colinmarc/novy/hardware/chain.png

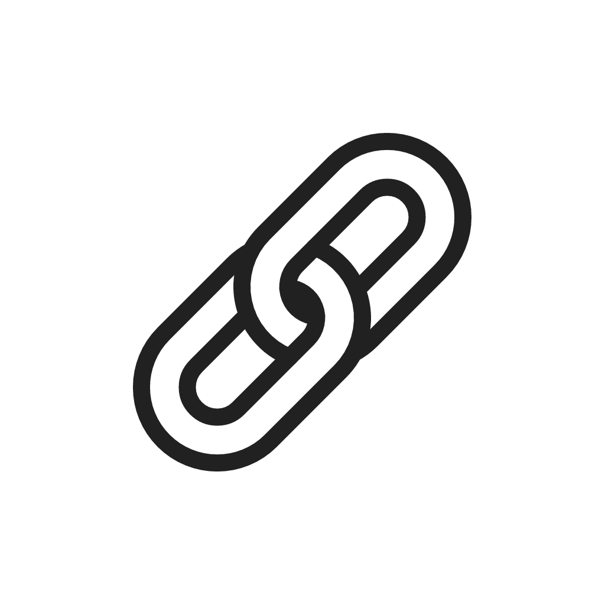
hardware/chain.png
