colinmarc/novy/hardware/front.dxf

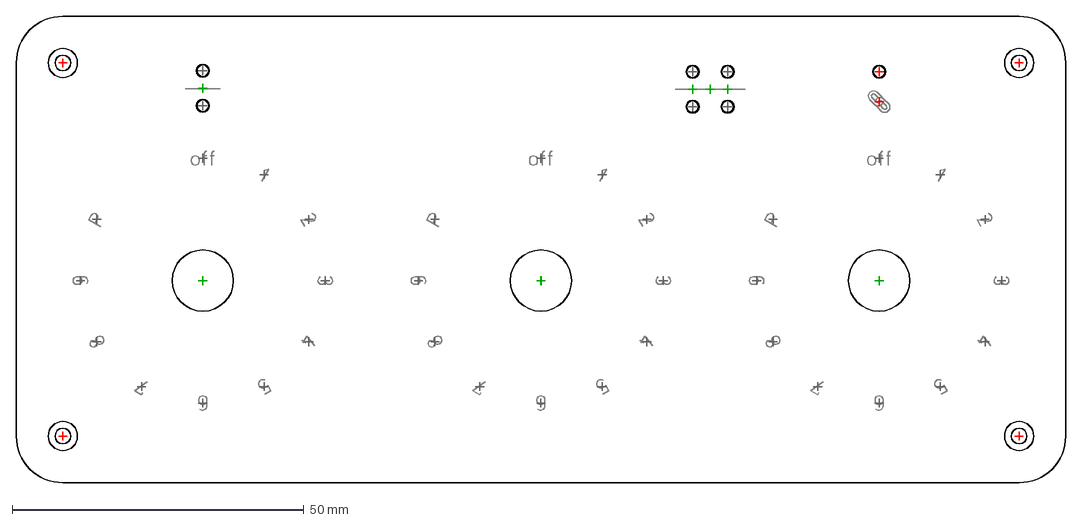
[picture p2: CAD file, 2026-05-25]
hardware/front.dxf
180.0 x 80.0 mm
