colinmarc/novy/hardware/novy/novy.kicad_pcb

## KiCad design hardware/novy/novy.kicad_pcb (2026-07-04)

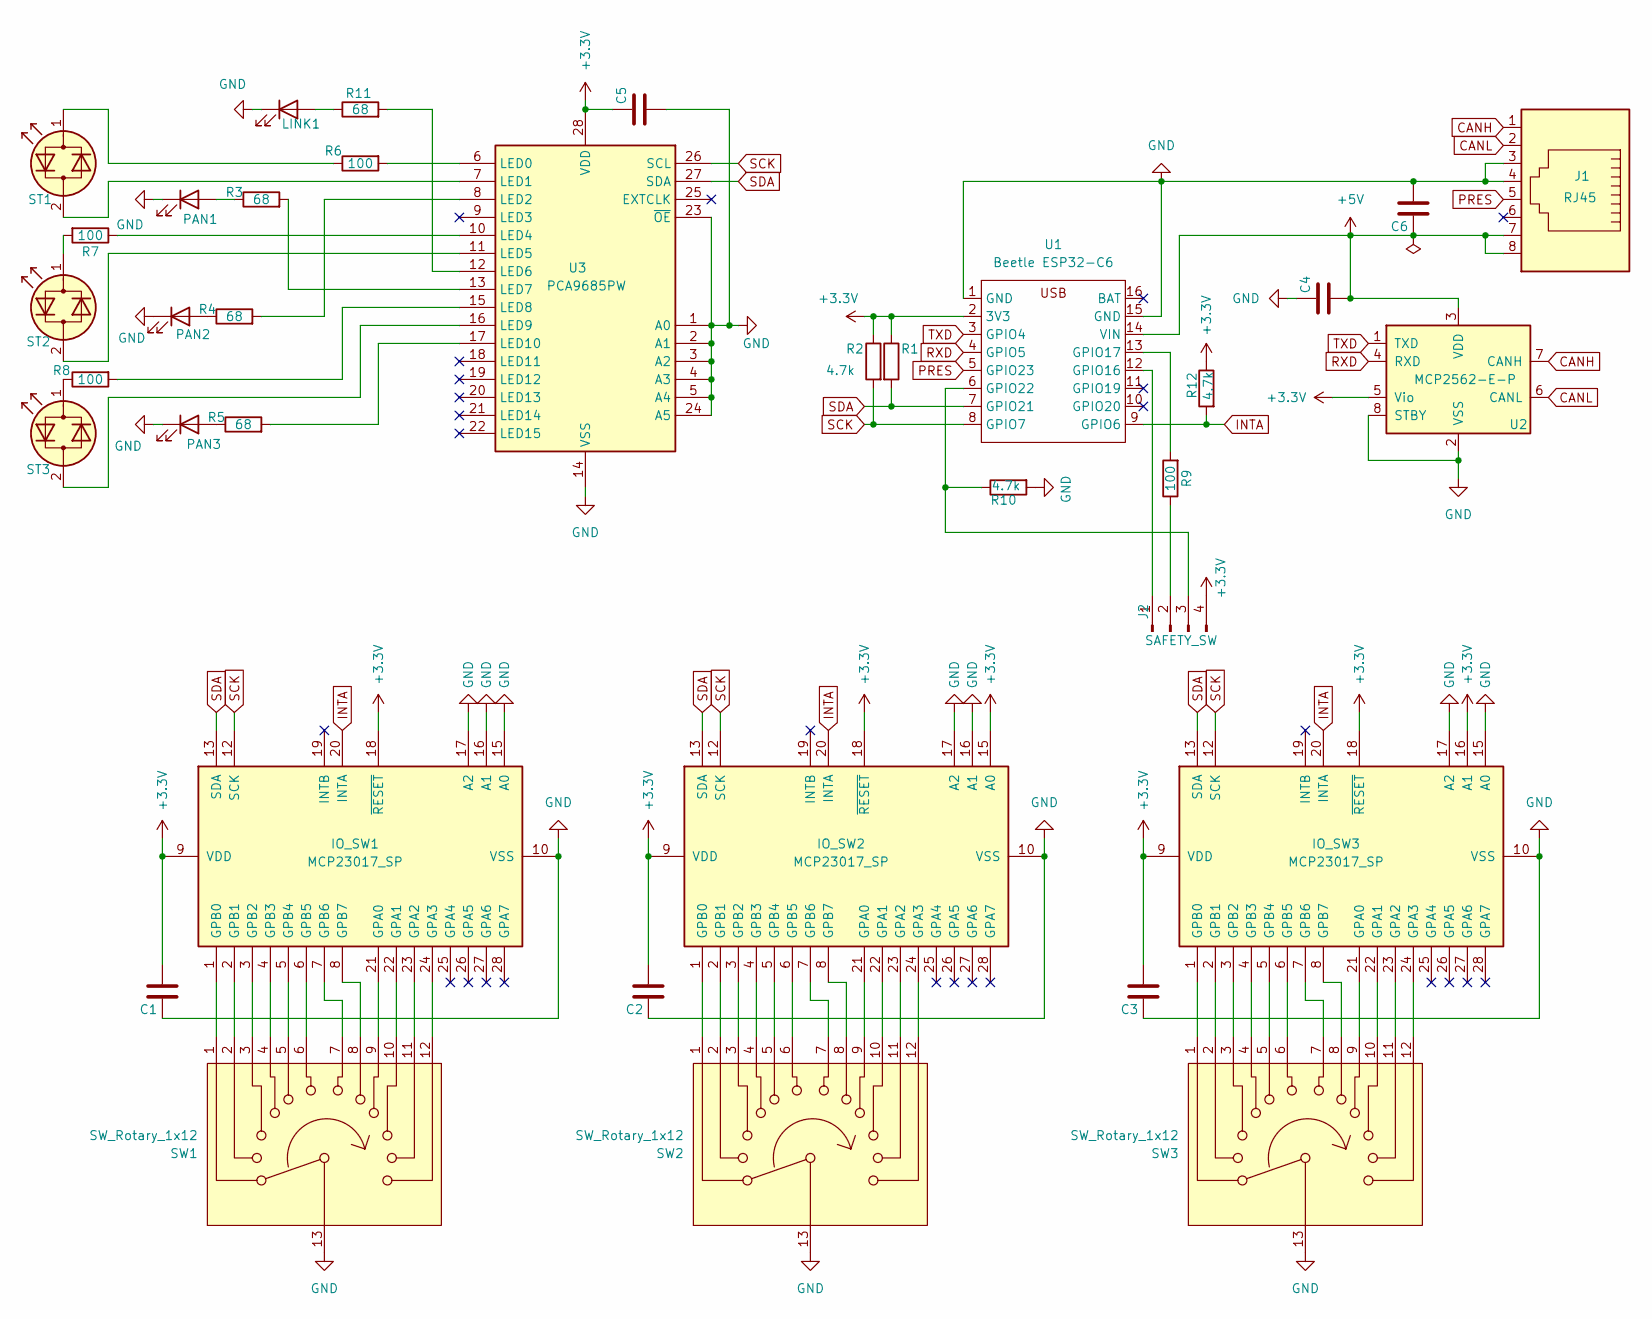
[picture p3: schematic novy.kicad_sch]

Parts:
C1, C2, C3, C4, C5: C; C_Rect_L7.0mm_W2.0mm_P5.00mm
C6: 10uF; C_Rect_L7.0mm_W2.0mm_P5.00mm
IO_SW1, IO_SW2, IO_SW3: MCP23017_SP; DIP-28_W7.62mm
J1: RJ45; RJ45_Amphenol_54602-x08_Horizontal
J2: SAFETY_SW; PinHeader_1x04_P2.54mm_Vertical
LINK1: LED_D3.0mm
PAN1: LED_D3.0mm
PAN2: PAN2; LED_D3.0mm
PAN3: PAN3; LED_D3.0mm
R1, R2, R10, R12: 4.7k; R_0603_1608Metric_Pad0.98x0.95mm_HandSolder
R3, R4, R5, R11: 68; R_0603_1608Metric_Pad0.98x0.95mm_HandSolder
R6, R7, R8, R9: 100; R_0603_1608Metric_Pad0.98x0.95mm_HandSolder
ST1, ST2, ST3: LED_Dual_Bidirectional; LED_D3.0mm
SW1, SW2, SW3: SW_Rotary_1x12; Elma_04-1124-20
U1: Beetle ESP32-C6; esp32-c6-beetle
U2: MCP2562-E-P; DIP-8_W7.62mm
U3: PCA9685PW; TSSOP-28_4.4x9.7mm_P0.65mm

Connections:
+5V: C4.1, C6.2, J1.7, J1.8, U1.14 (VIN), U2.3 (VDD)
CANH: J1.1, U2.7 (CANH); also elsewhere on the board
CANL: J1.2, U2.6 (CANL); also elsewhere on the board
GND: C1.2, C2.2, C3.2, C4.2, C5.1, C6.1, IO_SW1.10 (VSS), IO_SW1.15 (A0), IO_SW1.16 (A1), IO_SW1.17 (A2), IO_SW2.10 (VSS), IO_SW2.16 (A1), IO_SW2.17 (A2), IO_SW3.10 (VSS), IO_SW3.15 (A0), IO_SW3.17 (A2), J1.3, J1.4, LINK1.1 (K), PAN1.1 (K), PAN2.1 (K), PAN3.1 (K), R10.2, SW1.13, SW2.13, SW3.13, U1.1 (GND), U1.15 (GND), U2.2 (VSS), U2.8 (STBY), U3.1 (A0), U3.2 (A1), U3.3 (A2), U3.4 (A3), U3.5 (A4), U3.14 (VSS), U3.23 (~OE), U3.24 (A5)
INTA: IO_SW1.20 (INTA), IO_SW2.20 (INTA), IO_SW3.20 (INTA), R12.2, U1.9 (GPIO6)
unnamed: IO_SW1.21 (GPA0), SW1.9
unnamed: IO_SW1.22 (GPA1), SW1.10
unnamed: IO_SW1.23 (GPA2), SW1.11
unnamed: IO_SW1.24 (GPA3), SW1.12
unnamed: IO_SW1.1 (GPB0), SW1.1
unnamed: IO_SW1.2 (GPB1), SW1.2
unnamed: IO_SW1.3 (GPB2), SW1.3
unnamed: IO_SW1.4 (GPB3), SW1.4
unnamed: IO_SW1.5 (GPB4), SW1.5
unnamed: IO_SW1.6 (GPB5), SW1.6
unnamed: IO_SW1.7 (GPB6), SW1.7
unnamed: IO_SW1.8 (GPB7), SW1.8
unnamed: IO_SW2.21 (GPA0), SW2.9
unnamed: IO_SW2.22 (GPA1), SW2.10
unnamed: IO_SW2.23 (GPA2), SW2.11
unnamed: IO_SW2.24 (GPA3), SW2.12
unnamed: IO_SW2.1 (GPB0), SW2.1
unnamed: IO_SW2.2 (GPB1), SW2.2
unnamed: IO_SW2.3 (GPB2), SW2.3
unnamed: IO_SW2.4 (GPB3), SW2.4
unnamed: IO_SW2.5 (GPB4), SW2.5
unnamed: IO_SW2.6 (GPB5), SW2.6
unnamed: IO_SW2.7 (GPB6), SW2.7
unnamed: IO_SW2.8 (GPB7), SW2.8
unnamed: IO_SW3.21 (GPA0), SW3.9
unnamed: IO_SW3.22 (GPA1), SW3.10
unnamed: IO_SW3.23 (GPA2), SW3.11
unnamed: IO_SW3.24 (GPA3), SW3.12
unnamed: IO_SW3.1 (GPB0), SW3.1
unnamed: IO_SW3.2 (GPB1), SW3.2
unnamed: IO_SW3.3 (GPB2), SW3.3
unnamed: IO_SW3.4 (GPB3), SW3.4
unnamed: IO_SW3.5 (GPB4), SW3.5
unnamed: IO_SW3.6 (GPB5), SW3.6
unnamed: IO_SW3.7 (GPB6), SW3.7
unnamed: IO_SW3.8 (GPB7), SW3.8
unnamed: J2.1, U1.12 (GPIO16)
unnamed: J2.2, R9.1
unnamed: J2.3, R10.1, U1.6 (GPIO22)
unnamed: LINK1.2 (A), R11.1
unnamed: PAN1.2 (A), R3.1
unnamed: PAN2.2 (A), R4.1
unnamed: PAN3.2 (A), R5.1
unnamed: ST1.2 (AK), U3.7 (LED1)
unnamed: R6.1, ST1.1 (KA)
unnamed: ST2.2 (AK), U3.11 (LED5)
unnamed: R7.2, ST2.1 (KA)
unnamed: ST3.2 (AK), U3.16 (LED9)
unnamed: R8.1, ST3.1 (KA)
unnamed: R9.2, U1.13 (GPIO17)
unnamed: R6.2, U3.6 (LED0)
unnamed: R4.2, U3.8 (LED2)
unnamed: R7.1, U3.10 (LED4)
unnamed: R11.2, U3.12 (LED6)
unnamed: R3.2, U3.13 (LED7)
unnamed: R8.2, U3.15 (LED8)
unnamed: R5.2, U3.17 (LED10)
RXD: U1.4 (GPIO5), U2.4 (RXD)
SCK: IO_SW1.12 (SCK), IO_SW2.12 (SCK), IO_SW3.12 (SCK), R2.2, U1.8 (GPIO7), U3.26 (SCL)
SDA: IO_SW1.13 (SDA), IO_SW2.13 (SDA), IO_SW3.13 (SDA), R1.2, U1.7 (GPIO21), U3.27 (SDA)
TXD: U1.3 (GPIO4), U2.1 (TXD)

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
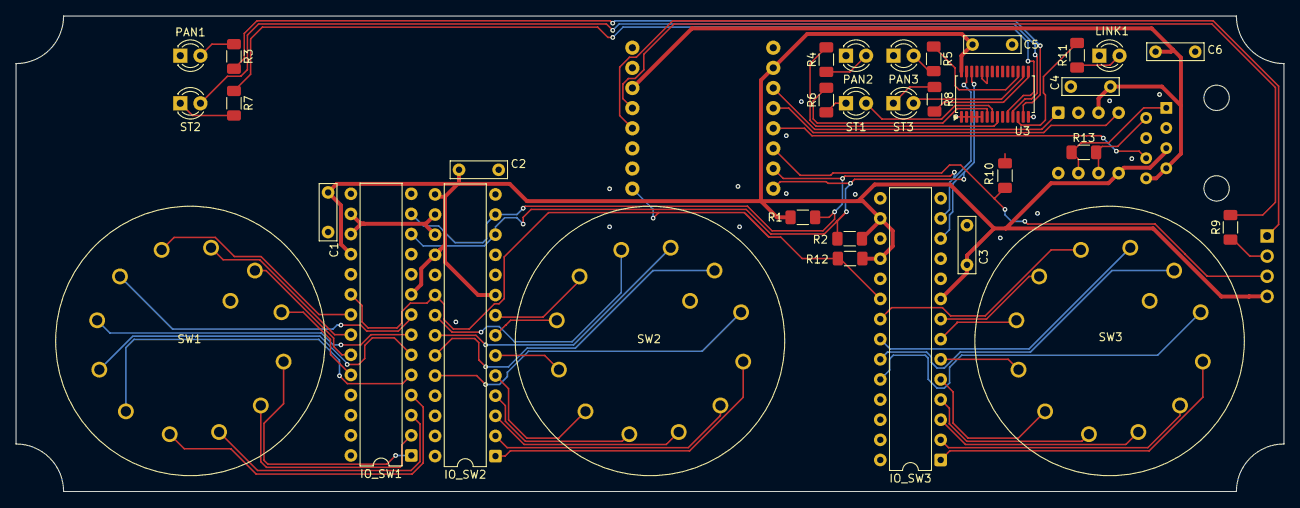
[picture p4: board novy.kicad_pcb from above]

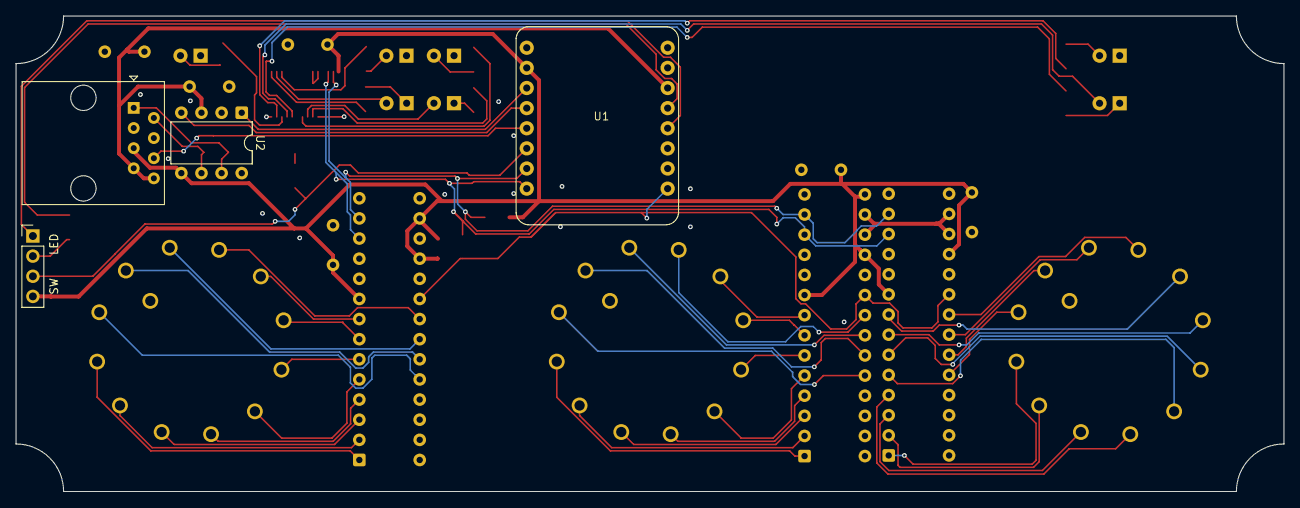
[picture p5: board novy.kicad_pcb from below]

Board: 2 copper layers, 160.0 x 60.0 mm, 37 parts (4 on the bottom side), 68 nets.

Other parts of the board:
R13: 120; R_1206_3216Metric_Pad1.30x1.75mm_HandSolder

Their connections:
CANH: R13.1; also elsewhere on the board
CANL: R13.2; also elsewhere on the board
