colinmarc/novy/(commit log)

2026-05-25 working prototype
    [novy.kicad_pcb, novy.kicad_sch]
2026-07-04 working firmware
    [novy.kicad_pcb]
